gbhug5a/Roku-Sling-IR-Channel-Number-Remote/Roku-Sling Remote1.jpg

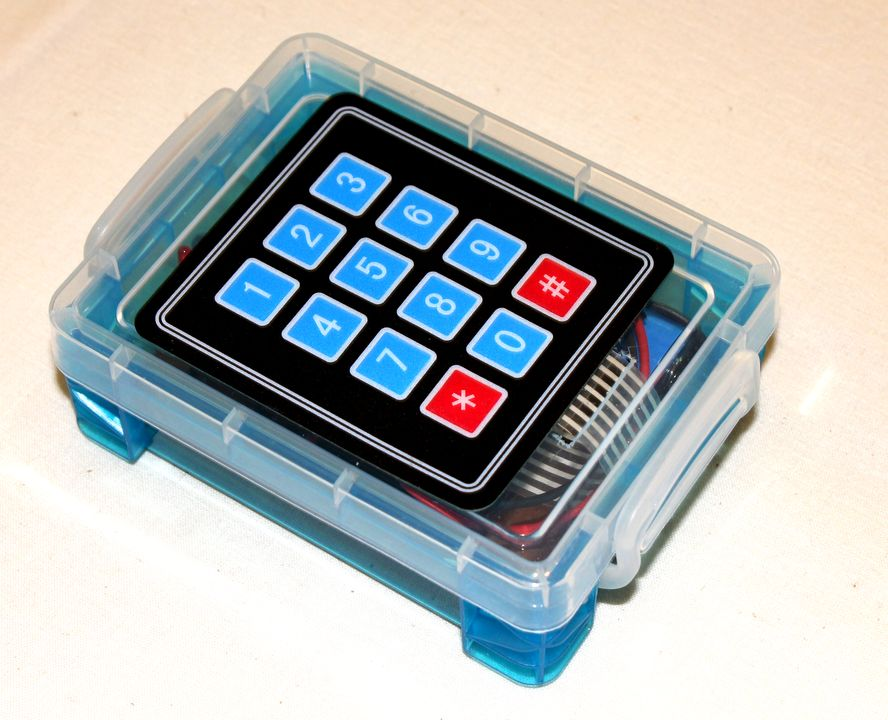
Roku-Sling Remote1.jpg
