gbhug5a/Roku-Sling-IR-Channel-Number-Remote/Roku-Sling Remote2.jpg

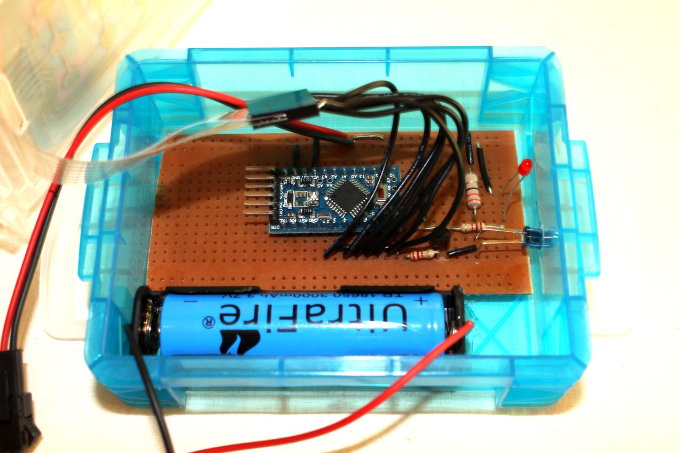
Roku-Sling Remote2.jpg
