gbhug5a/Roku-Sling-IR-Channel-Number-Remote/Schematic-alternate.png

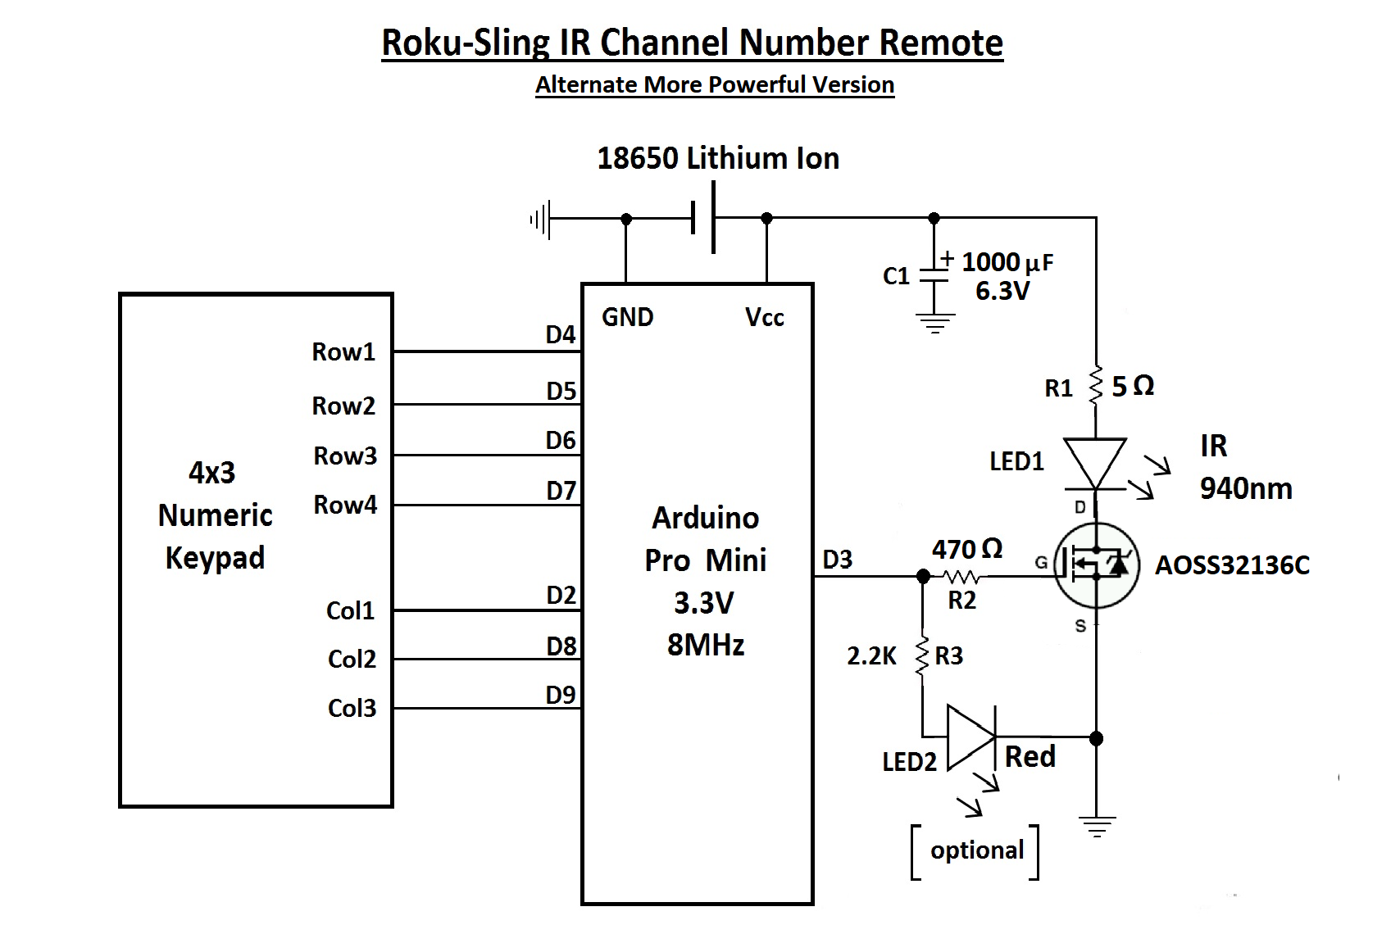
Schematic-alternate.png
