gbhug5a/Roku-Sling-IR-Channel-Number-Remote/Schematic.jpg

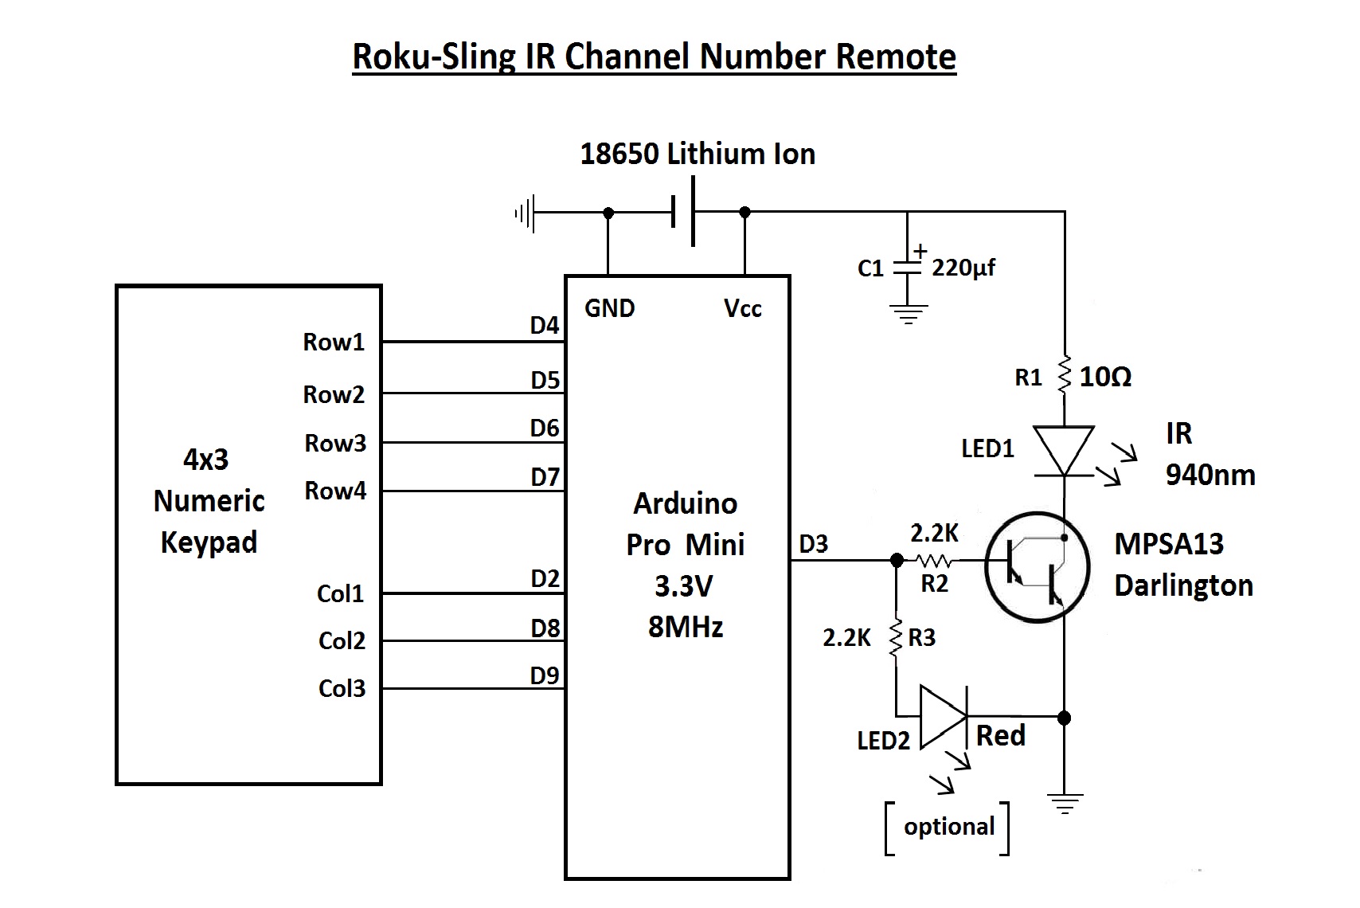
Schematic.jpg
